TEJAS-L-1729/variable-pitch-propeller-test-bench/cad/whole.SLDASM

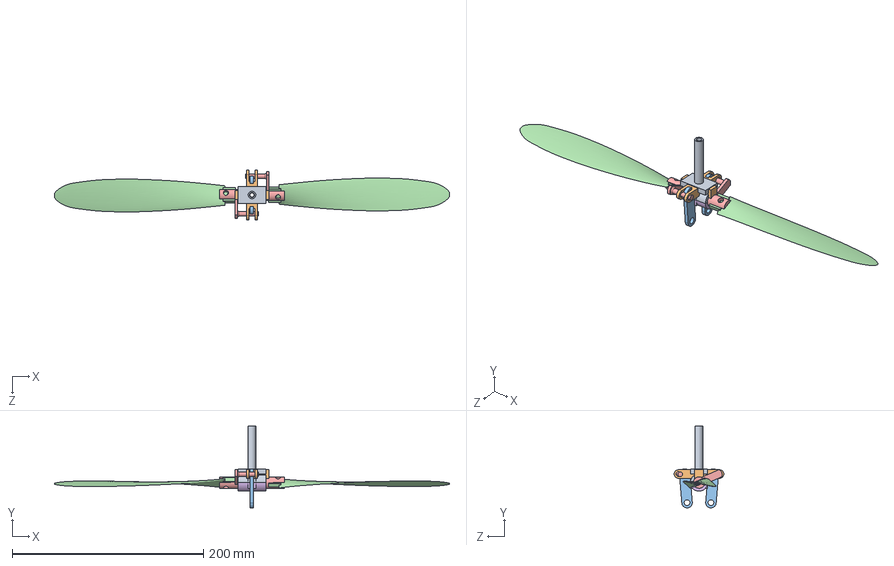
[picture p38: CAD file, 2026-08-21]
cad/whole.SLDASM
412.7 x 85.5 x 51.9 mm
hub
coupler x 2
WING x 2
string x 2
CONT
hub1
