TEJAS-L-1729/variable-pitch-propeller-test-bench/cad/Assem1.SLDASM

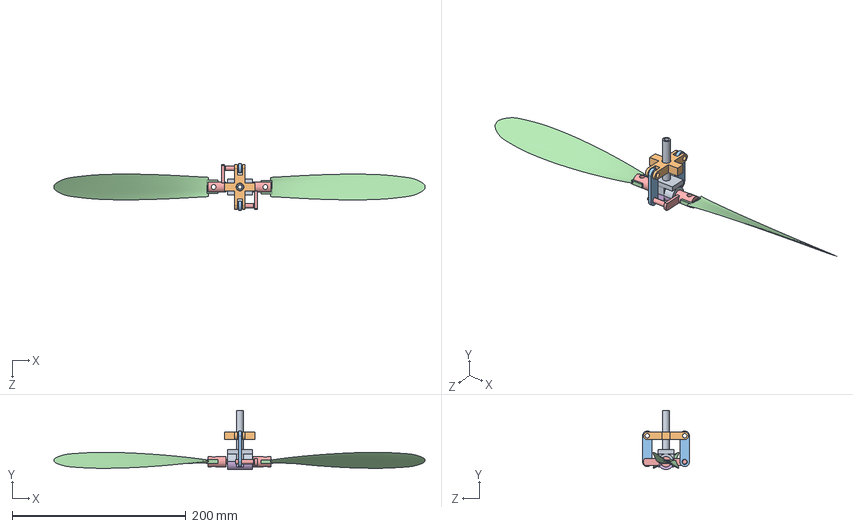
[picture p39: CAD file, 2026-08-21]
cad/Assem1.SLDASM
426.9 x 68.0 x 54.0 mm
hub
coupler x 2
WING x 2
string x 2
CONT
hub1
