TEJAS-L-1729/variable-pitch-propeller-test-bench/cad/print1.SLDASM

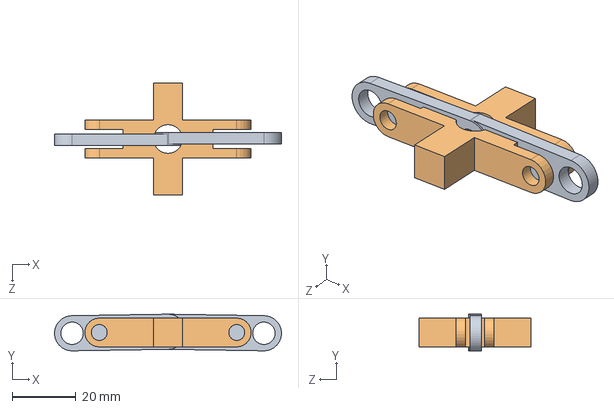
[picture p40: CAD file, 2026-08-21]
cad/print1.SLDASM
71.0 x 11.5 x 35.0 mm
CONT
string x 2
