TEJAS-L-1729/variable-pitch-propeller-test-bench/cad/assembeled.STL

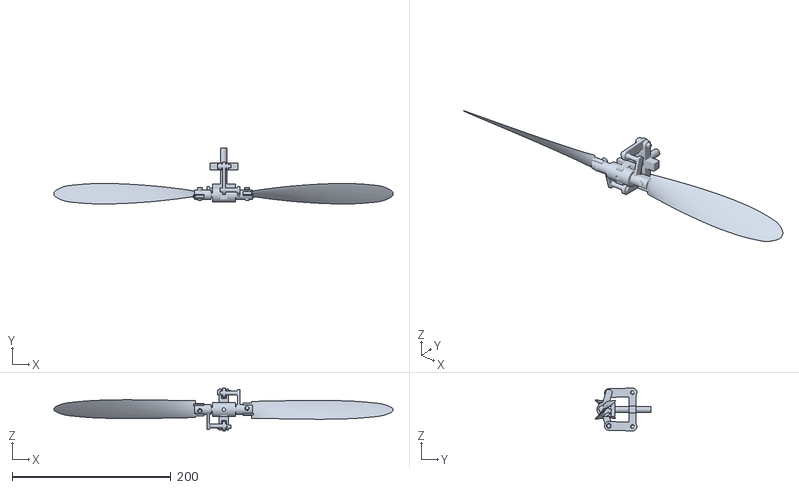
[picture p41: CAD file, 2026-08-31]
cad/assembeled.STL
426.9 x 70.3 x 54.0
