TEJAS-L-1729/variable-pitch-propeller-test-bench/cad/print1-string-1.STL

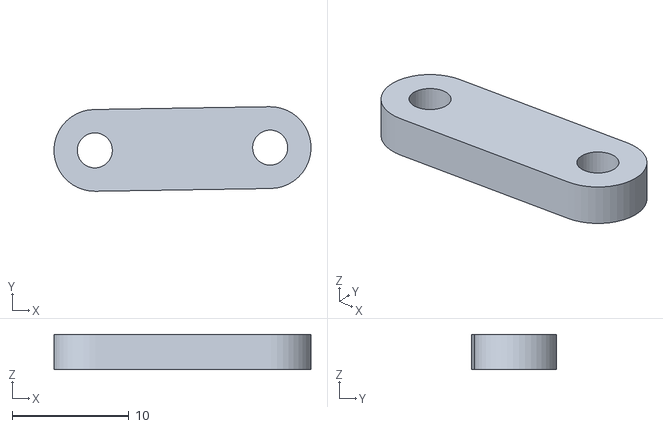
[picture p42: CAD file, 2026-08-31]
cad/print1-string-1.STL
22.0 x 7.24 x 3.00
