TEJAS-L-1729/variable-pitch-propeller-test-bench/cad/print1-CONT-1.STL

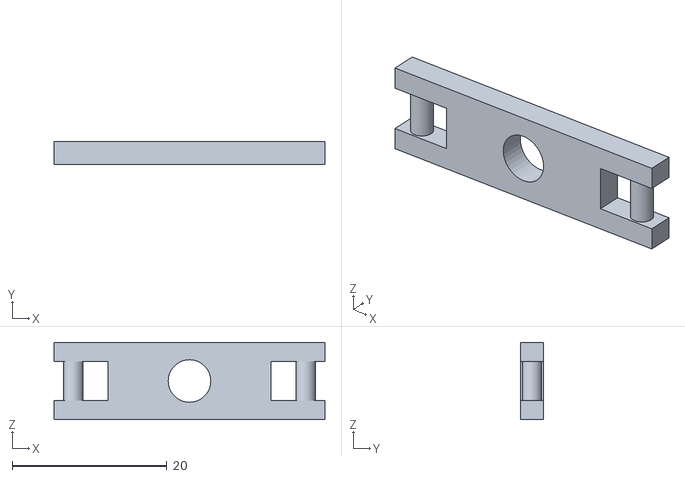
[picture p43: CAD file, 2026-08-31]
cad/print1-CONT-1.STL
35.0 x 3.00 x 10.0
