TEJAS-L-1729/variable-pitch-propeller-test-bench/cad/WING.SLDPRT

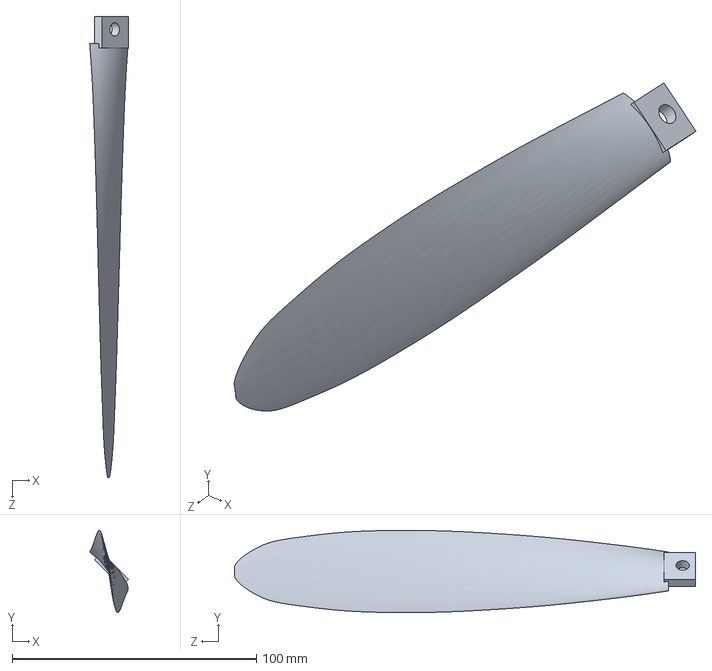
[picture p44: CAD file, 2026-08-21]
cad/WING.SLDPRT
15.8 x 33.7 x 188.9 mm
