TEJAS-L-1729/variable-pitch-propeller-test-bench/cad/string.SLDPRT

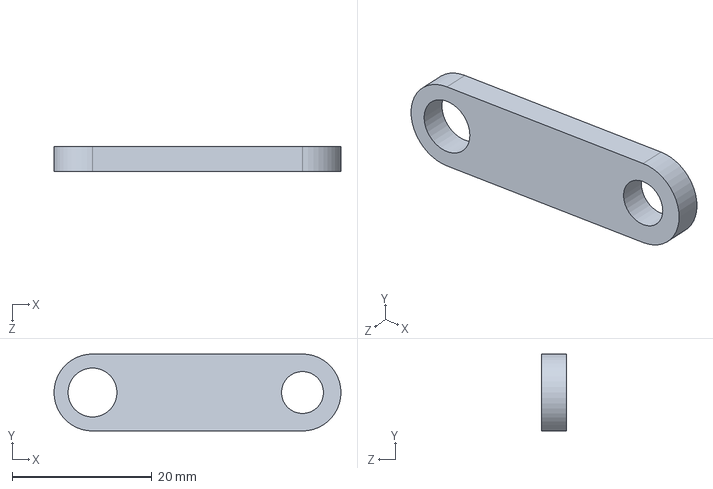
[picture p45: CAD file, 2026-08-21]
cad/string.SLDPRT
41.0 x 11.0 x 3.50 mm
