TEJAS-L-1729/variable-pitch-propeller-test-bench/cad/CONT.SLDPRT

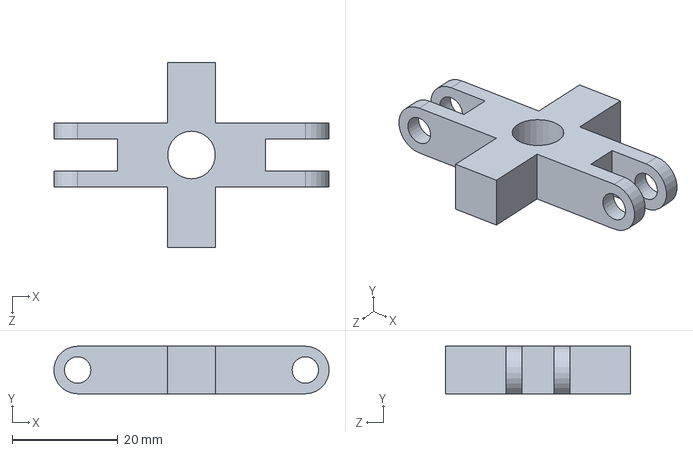
[picture p46: CAD file, 2026-08-21]
cad/CONT.SLDPRT
51.9 x 9.00 x 35.0 mm
