TEJAS-L-1729/variable-pitch-propeller-test-bench/cad/hub1.SLDPRT

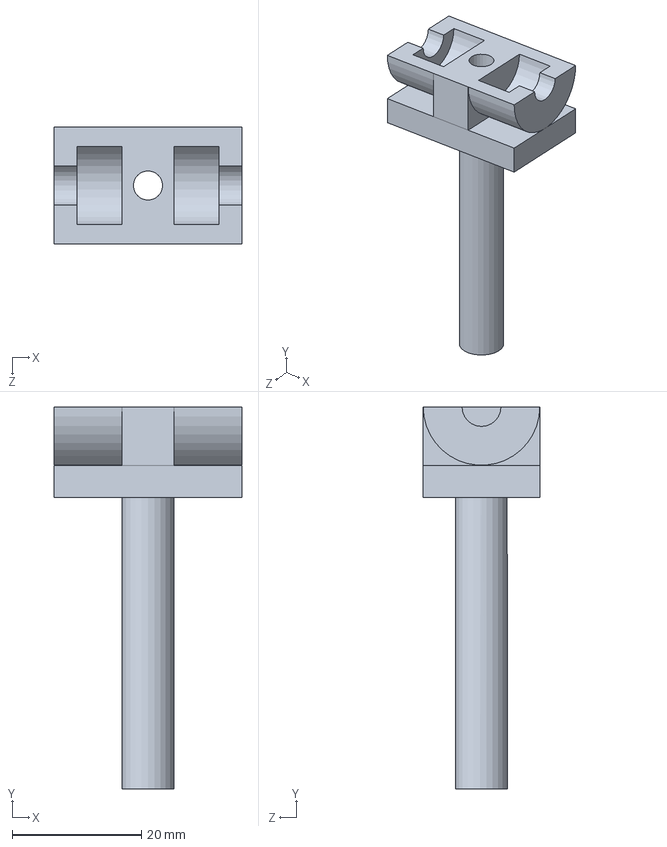
[picture p47: CAD file, 2026-08-21]
cad/hub1.SLDPRT
29.0 x 59.0 x 18.0 mm
