TEJAS-L-1729/variable-pitch-propeller-test-bench/cad/Part2.SLDPRT

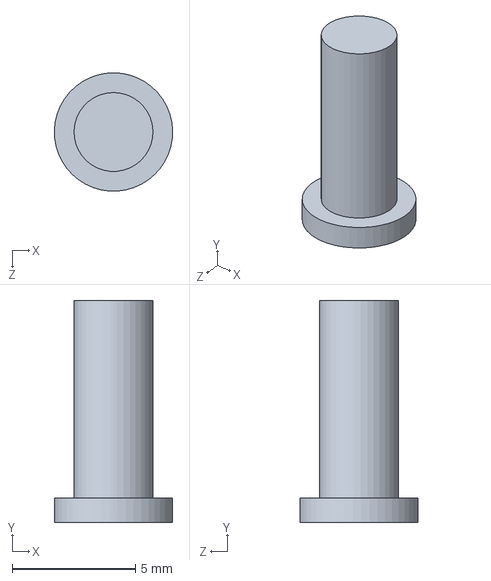
[picture p48: CAD file, 2026-08-21]
cad/Part2.SLDPRT
4.80 x 9.00 x 4.80 mm
