TEJAS-L-1729/variable-pitch-propeller-test-bench/cad/coupler.SLDPRT

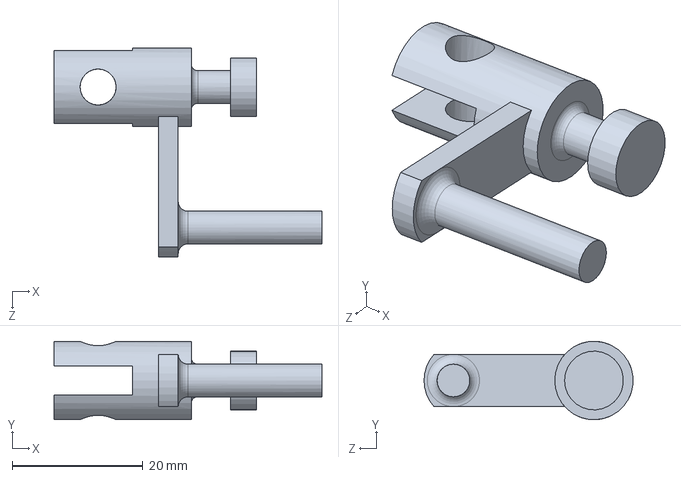
[picture p49: CAD file, 2026-08-21]
cad/coupler.SLDPRT
41.0 x 12.0 x 32.0 mm
