TEJAS-L-1729/variable-pitch-propeller-test-bench/cad/p1.STL

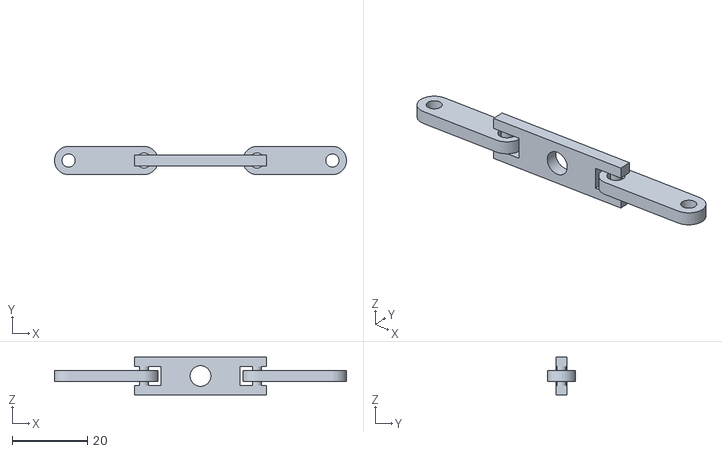
[picture p50: CAD file, 2026-08-21]
cad/p1.STL
77.5 x 7.50 x 10.0
