TEJAS-L-1729/variable-pitch-propeller-test-bench/cad/printable.SLDPRT

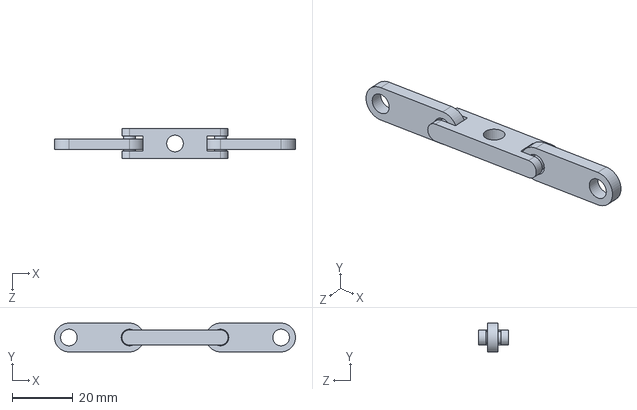
[picture p51: CAD file, 2026-08-21]
cad/printable.SLDPRT
79.5 x 9.50 x 10.0 mm
