TEJAS-L-1729/variable-pitch-propeller-test-bench/cad/hub.SLDPRT

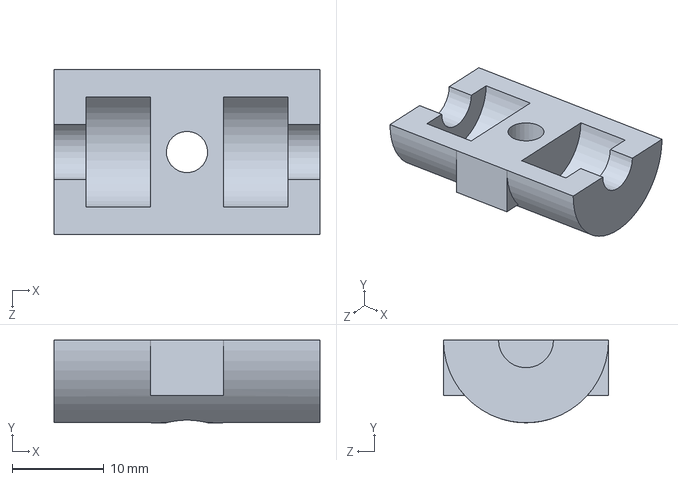
[picture p52: CAD file, 2026-08-21]
cad/hub.SLDPRT
29.0 x 9.00 x 18.0 mm
