TEJAS-L-1729/variable-pitch-propeller-test-bench/cad/p2.STL

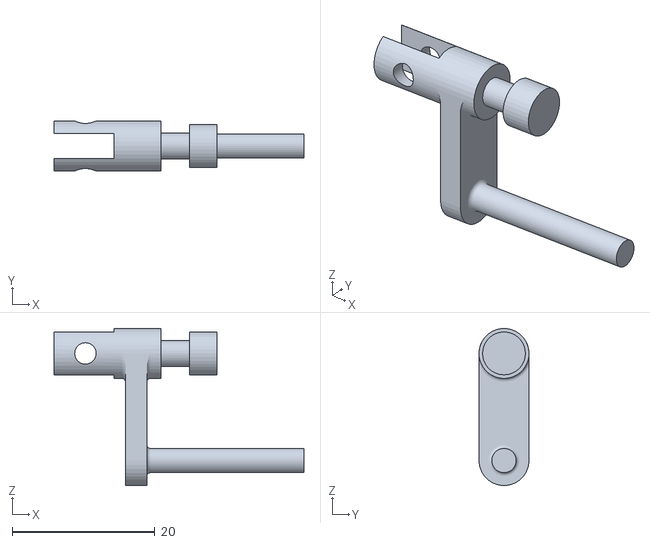
[picture p53: CAD file, 2026-08-21]
cad/p2.STL
35.0 x 7.00 x 22.0
