TEJAS-L-1729/variable-pitch-propeller-test-bench/(list of files, cad)

Other CAD files:
cad/print1-string-2.STL
cad/p3.STL
cad/bolt1.SLDPRT
cad/bolt2.SLDPRT
cad/bolts.STL
cad/print1 - CONT-1.STL
cad/print1 - string-1.STL
cad/print1 - string-2.STL
