TEJAS-L-1729/variable-pitch-propeller-test-bench/(commit log)

2026-08-31 Rename print1 - CONT-1.STL to print1-CONT-1.STL
    [print1-CONT-1.STL]
2026-08-31 Rename print1 - string-2.STL to print1-string-2.STL
    [print1-string-2.STL]
2026-08-31 Add print1-string-1.STL file
    [print1-string-1.STL]
2026-08-31 assembeled cad stl
    [assembeled.STL]
